f4grx/ol13/README.md

# ol13
1888 local oscillator, made after DF6NP design.
