f4grx/ol13/grx13.pdf

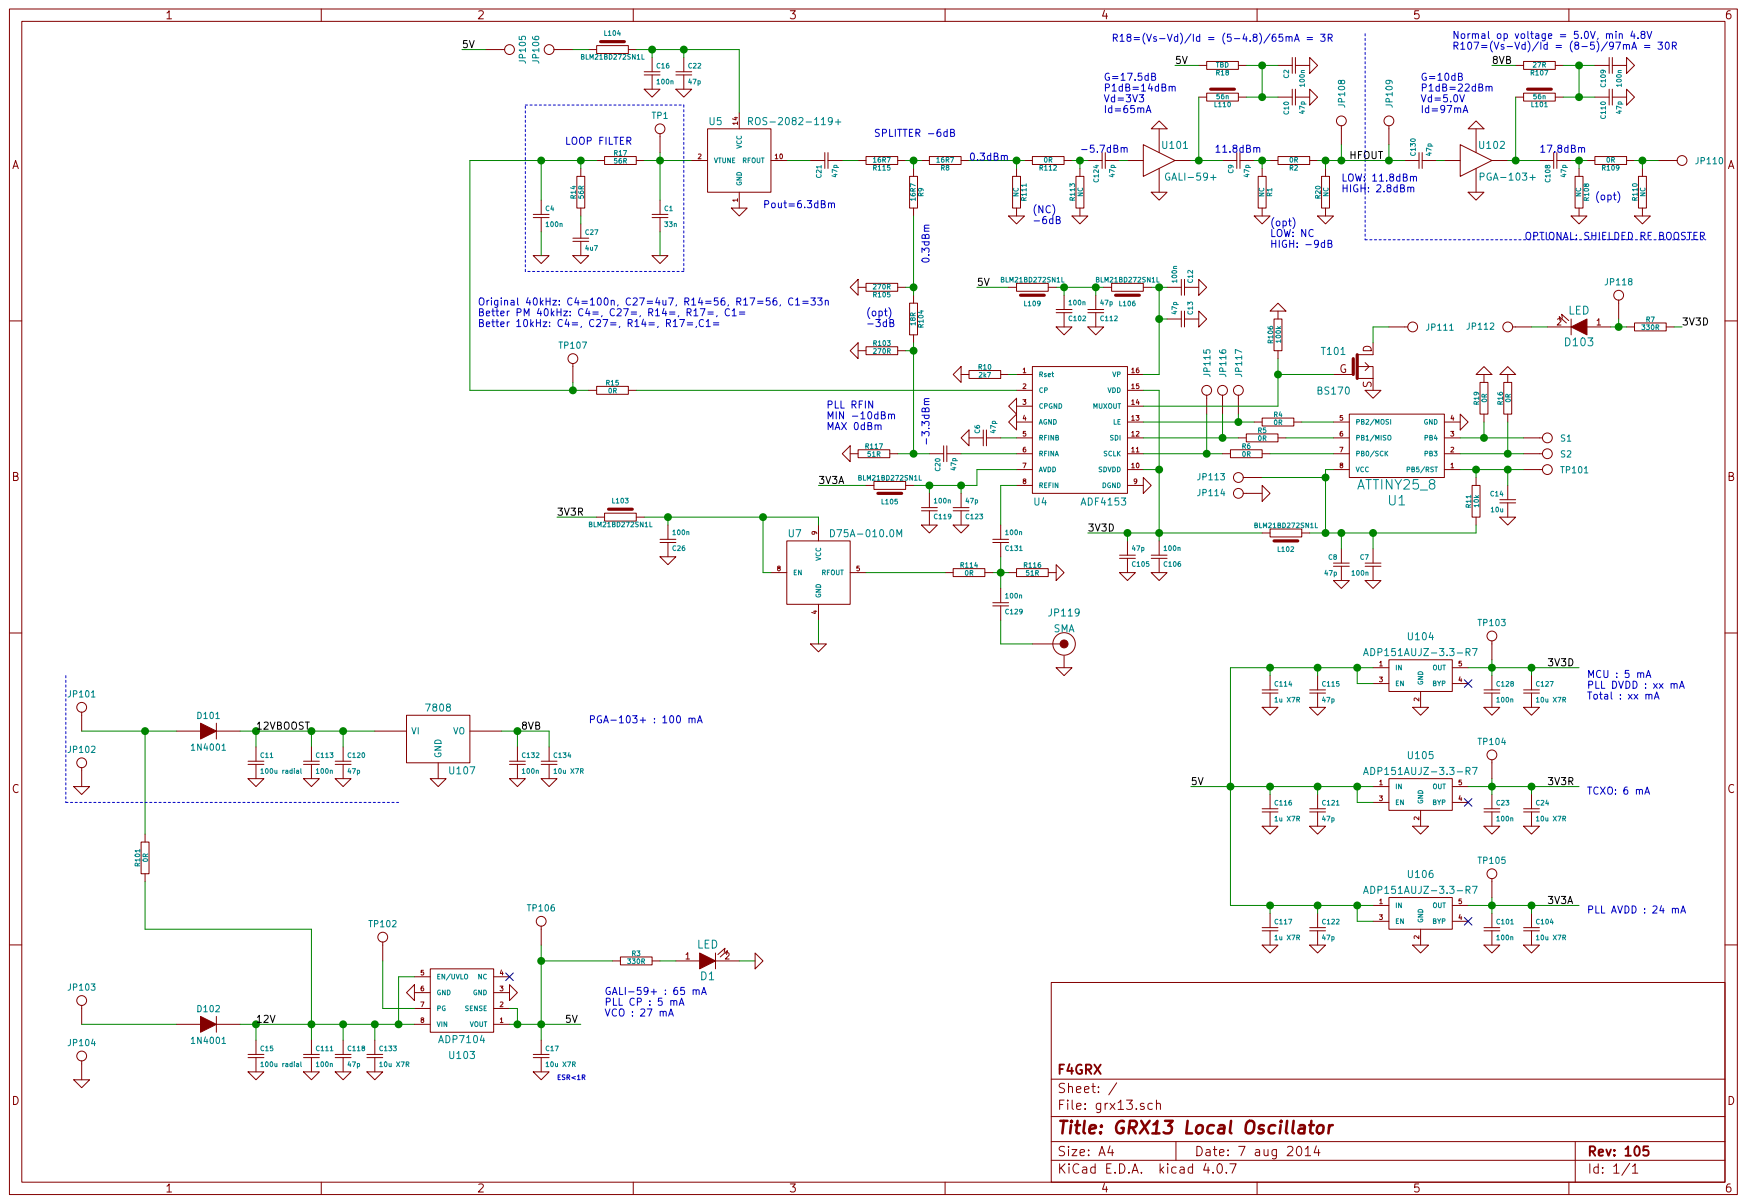
[picture p1: page 1]
