f4grx/ol13/grx13.kicad_pcb

## KiCad design grx13.kicad_pcb (2018-02-24)

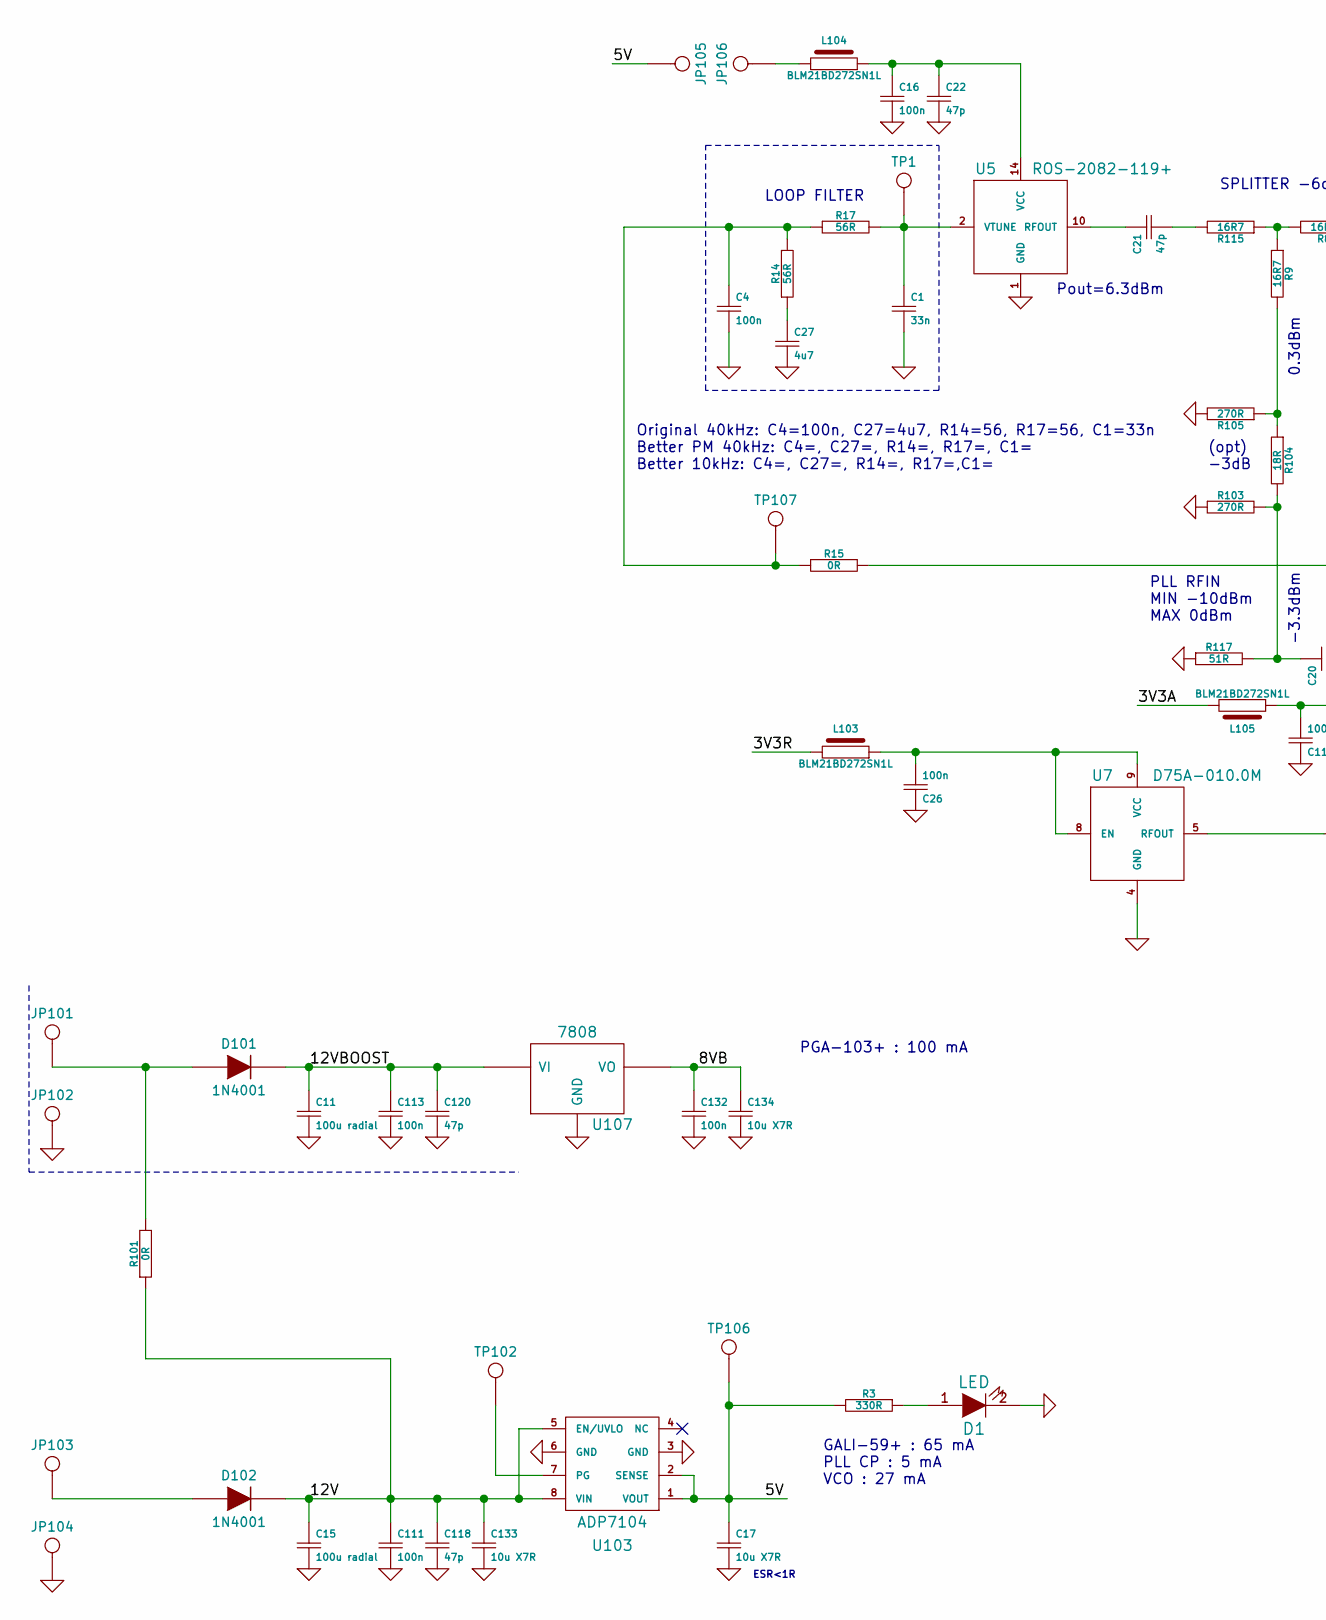
[picture p2: schematic grx13.sch, GRX13 Local Oscillator, part in row 1, column 1]

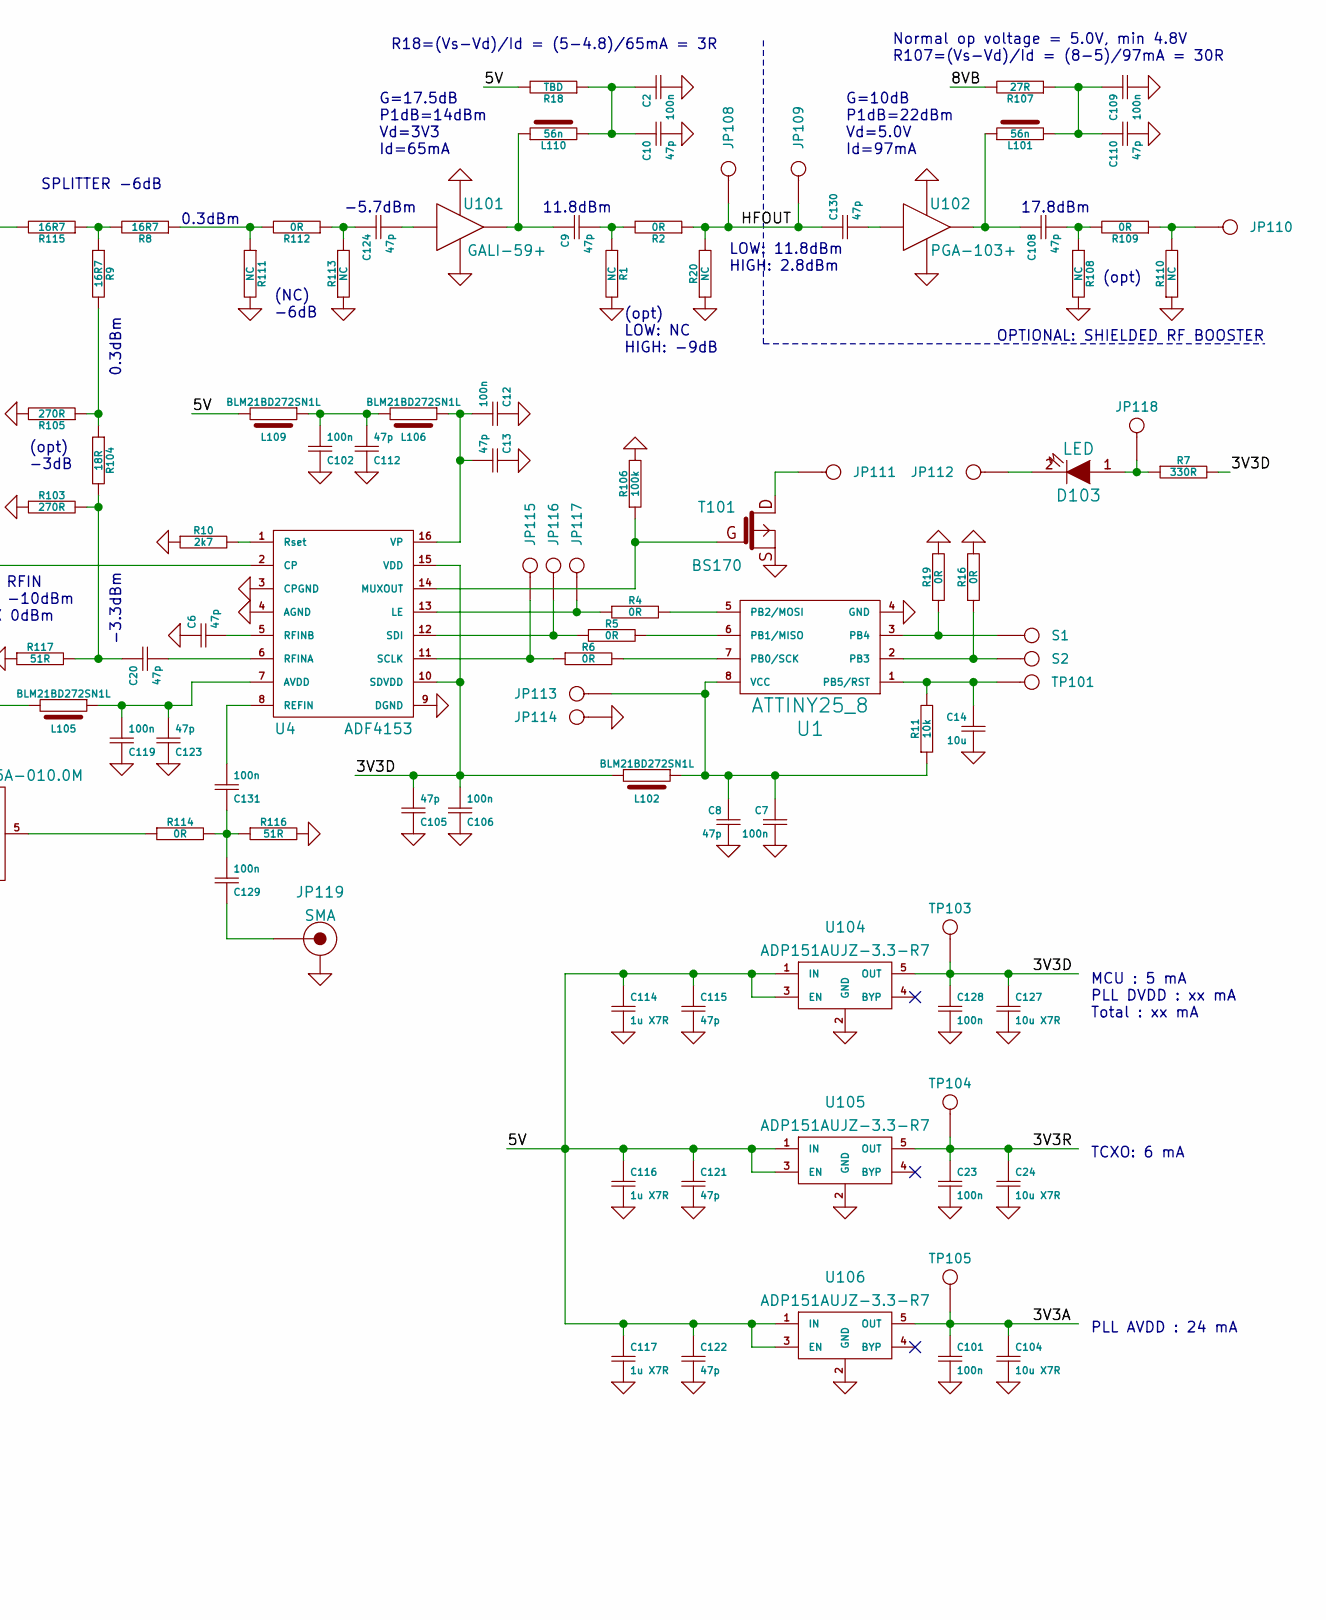
[picture p3: schematic grx13.sch, GRX13 Local Oscillator, part in row 1, column 2]

Parts:
C1: 33n; 0805
C2, C7, C12, C16, C23, C26, C101, C102, C106, C109, C111, C113, C119, C128, C129, C131, C132: 100n; 0805; PartNo 08055C104KAT2A; Farnell 499687
C4: 100n; 0805
C6, C8, C9, C10, C13, C20, C21, C22, C105, C108, C110, C112, C115, C118, C120, C121, C122, C123, C124, C130: 47p; 0805; PartNo 08051A470JAT2A; Farnell 499160
C11, C15: 100u radial; C2V8
C14: 10u; 1206
C17, C24, C104, C127, C133: 10u X7R; 1206; PartNo 1206YC106KAT2A; Farnell 1657943
C27: 4u7; 1206
C114: 1u X7R; 0805; PartNo C2012X7S2A105K125AB
C116, C117: 1u X7R; 0805
C134: 10u X7R; 1206; PartNo 1206YC106KAT2A
D1, D103: LED; 0805
D101, D102: 1N4001; D4
JP101: CONN_1; HOLE_PTH_R_08_16; PartNo nobom; Farnell F
JP102, JP103, JP104, JP105, JP106, JP111, JP112, JP113, JP114, JP115, JP116, JP117, JP118: CONN_1; HOLE_PTH_R_08_16; PartNo nobom
JP108, JP109, JP110: CONN_1; HOLE_SMD_S_15; PartNo nobom
JP119: SMA; SMA_TH; PartNo nobom
L101, L110: 56n; 0805
L102, L103, L104, L105, L106, L109: BLM21BD272SN1L; 0805; PartNo BLM21BD272SN1L; Farnell 1515647
R1, R20, R108, R110, R111, R113: NC; 0805
R2, R4, R5, R6, R15, R16, R19, R101, R109, R112, R114: 0R; 0805
R3, R7: 330R; 0805
R8, R9, R115: 16R7; 0805
R10: 2k7; 0805
R11: 10k; 0805
R14, R17: 56R; 0805
R18: TBD; 1206
R103, R105: 270R; 0805
R104: 18R; 0805
R106: 100k; 0805
R107: 27R; 1206
R116, R117: 51R; 0805
S1, S2: CONN_1; HOLE_PTH_R_08_16; PartNo nobom
T101: BS170; SOT23GDS; PartNo BS170FTA; Farnell 9526005
TP1, TP101, TP102, TP103, TP104, TP105, TP106, TP107: CONN_1; HOLE_PTH_R_06_12; PartNo nobom
U1: ATTINY25_8; SO8N; PartNo ATTINY25V-10SSU
U4: ADF4153; TSSOP16; PartNo ADF4153ABRUZ; Mouser 584-ADF4153ABRUZ
U5: ROS-2082-119+; CK605; PartNo ROS-2082-119+; Farnell NA
U7: D75A-010.0M; D75A; PartNo D75A-010.0M; Farnell NA
U101: GALI-59+; SOT89; PartNo GALI-59+; Farnell NA
U102: PGA-103+; SOT89; PartNo PGA-103+; Farnell NA
U103: ADP7104; SO8N; PartNo ADP7104ARDZ-5.0-R7; Farnell NA
U104, U105, U106: ADP151AUJZ-3.3-R7; SOT23-5; PartNo ADP151AUJZ-3.3-R7; Mouser 584-ADP151AUJZ-3.3R7
U107: 7808; DPAK2; PartNo MC7808CDTT5G; Farnell 1652338

Connections:
/3V3A: C101.1, C104.1, L105.2 (OUT), TP105.1, U106.5 (OUT)
/3V3D: C105.2, C106.2, C127.1, C128.1, L102.2 (OUT), R7.2 (OUT), TP103.1, U4.10 (SDVDD), U4.15 (VDD), U104.5 (OUT)
/3V3R: C23.1, C24.1, L103.2 (OUT), TP104.1, U105.5 (OUT)
/5V: C17.1, C114.1, C115.1, C116.1, C117.1, C121.1, C122.1, JP105.1, L109.2 (OUT), R3.2 (OUT), R18.2 (OUT), TP106.1, U103.1 (VOUT), U103.2 (SENSE), U104.1 (IN), U104.3 (EN), U105.1 (IN), U105.3 (EN), U106.1 (IN), U106.3 (EN)
/8VB: C132.1, C134.1, R107.2 (OUT), U107.3 (VO)
/12V: C15.1, C111.1, C118.1, C133.1, D102.2 (K), R101.1 (IN), U103.5 (EN/UVLO), U103.8 (VIN)
/12VBOOST: C11.1, C113.1, C120.1, D101.2 (K), U107.1 (VI)
/HFOUT: C130.1, JP108.1, JP109.1, R2.1 (IN), R20.2 (OUT)
GND: C1.2, C2.2, C4.2, C6.1, C7.2, C8.2, C10.2, C11.2, C12.1, C13.1, C14.2, C15.2, C16.2, C17.2, C22.2, C23.2, C24.2, C26.1, C27.2, C101.2, C102.1, C104.2, C105.1, C106.1, C109.2, C110.2, C111.2, C112.1, C113.2, C114.2, C115.2, C116.2, C117.2, C118.2, C119.1, C120.2, C121.2, C122.2, C123.1, C127.2, C128.2, C132.2, C133.2, C134.2, D1.2 (K), JP102.1, JP104.1, JP114.1, JP119.2, R1.2 (OUT), R10.1 (IN), R16.2 (OUT), R19.2 (OUT), R20.1 (IN), R103.1 (IN), R105.2 (OUT), R106.2 (OUT), R108.2 (OUT), R110.1 (IN), R111.2 (OUT), R113.1 (IN), R116.2 (OUT), R117.1 (IN), T101.S, U1.4 (GND), U4.3 (CPGND), U4.4 (AGND), U4.9 (DGND), U5.1 (GND), U7.4 (GND), U101.2 (GND), U102.2 (GND), U103.3 (GND), U103.6 (GND), U104.2 (GND), U105.2 (GND), U106.2 (GND), U107.2 (GND)
unnamed: C1.1, R17.2 (OUT), TP1.1, U5.2 (VTUNE)
unnamed: C4.1, R14.2 (OUT), R15.1 (IN), R17.1 (IN), TP107.1
unnamed: C6.2, U4.5 (RFINB)
unnamed: C7.1, C8.1, JP113.1, L102.1 (IN), R11.1 (IN), U1.8 (VCC)
unnamed: C9.1, L110.1 (IN), U101.3 (OUT)
unnamed: C9.2, R1.1 (IN), R2.2 (OUT)
unnamed: C2.1, C10.1, L110.2 (OUT), R18.1 (IN)
unnamed: C12.2, C13.2, L106.1 (IN), U4.16 (VP)
unnamed: C14.1, R11.2 (OUT), TP101.1, U1.1 (PB5/RST)
unnamed: C16.1, C22.1, L104.1 (IN), U5.14 (VCC)
unnamed: C20.1, R103.2 (OUT), R104.2 (OUT), R117.2 (OUT)
unnamed: C20.2, U4.6 (RFINA)
unnamed: C21.1, U5.10 (RFOUT)
unnamed: C21.2, R115.2 (OUT)
unnamed: C26.2, L103.1 (IN), U7.8 (EN), U7.9 (VCC)
unnamed: C27.1, R14.1 (IN)
unnamed: C102.2, C112.2, L106.2 (OUT), L109.1 (IN)
unnamed: C108.1, L101.1 (IN), U102.3 (OUT)
unnamed: C108.2, R108.1 (IN), R109.2 (OUT)
unnamed: C109.1, C110.1, L101.2 (OUT), R107.1 (IN)
unnamed: C119.2, C123.2, L105.1 (IN), U4.7 (AVDD)
unnamed: C124.1, R112.1 (IN), R113.2 (OUT)
unnamed: C124.2, U101.1 (IN)
unnamed: C129.1, JP119.1
unnamed: C129.2, C131.1, R114.2 (OUT), R116.1 (IN)
unnamed: C130.2, U102.1 (IN)
unnamed: C131.2, U4.8 (REFIN)
unnamed: D1.1 (A), R3.1 (IN)
unnamed: D101.1 (A), JP101.1, R101.2 (OUT)
unnamed: D102.1 (A), JP103.1
unnamed: D103.1 (A), JP118.1, R7.1 (IN)
unnamed: D103.2 (K), JP112.1
unnamed: JP106.1, L104.2 (OUT)
unnamed: JP110.1, R109.1 (IN), R110.2 (OUT)
unnamed: JP111.1, T101.D
unnamed: JP115.1, R6.1 (IN), U4.11 (SCLK)
unnamed: JP116.1, R5.1 (IN), U4.12 (SDI)
unnamed: JP117.1, R4.1 (IN), U4.13 (LE)
unnamed: R4.2 (OUT), U1.5 (PB2/MOSI)
unnamed: R5.2 (OUT), U1.6 (PB1/MISO)
unnamed: R6.2 (OUT), U1.7 (PB0/SCK)
unnamed: R10.2 (OUT), U4.1 (Rset)
unnamed: R15.2 (OUT), U4.2 (CP)
unnamed: R16.1 (IN), S2.1, U1.2 (PB3)
unnamed: R19.1 (IN), S1.1, U1.3 (PB4)
unnamed: R9.2 (OUT), R104.1 (IN), R105.1 (IN)
unnamed: R106.1 (IN), T101.G, U4.14 (MUXOUT)
unnamed: R8.1 (IN), R111.1 (IN), R112.2 (OUT)
unnamed: R114.1 (IN), U7.5 (RFOUT)
unnamed: R8.2 (OUT), R9.1 (IN), R115.1 (IN)
unnamed: TP102.1, U103.7 (PG)

Notes on the sheet:
OPTIONAL: SHIELDED RF BOOSTER
(opt) -3dB
(NC) -6dB
(opt) LOW: NC HIGH: -9dB
LOOP FILTER
Pout=6.3dBm
SPLITTER -6dB
G=10dB P1dB=22dBm Vd=5.0V Id=97mA
G=17.5dB P1dB=14dBm Vd=3V3 Id=65mA
0.3dBm
PLL RFIN MIN -10dBm MAX 0dBm
-3.3dBm
-5.7dBm
11.8dBm
LOW: 11.8dBm HIGH: 2.8dBm
17.8dBm
(opt)
R18=(Vs-Vd)/Id = (5-4.8)/65mA = 3R
Normal op voltage = 5.0V, min 4.8V R107=(Vs-Vd)/Id = (8-5)/97mA = 30R
MCU : 5 mA PLL DVDD : xx mA Total : xx mA
TCXO: 6 mA
PLL AVDD : 24 mA
PGA-103+ : 100 mA
GALI-59+ : 65 mA PLL CP : 5 mA VCO : 27 mA
ESR<1R
Original 40kHz: C4=100n, C27=4u7, R14=56, R17=56, C1=33n Better PM 40kHz: C4=, C27=, R14=, R17=, C1= Better 10kHz: C4=, C27=, R14=, R17=,C1=

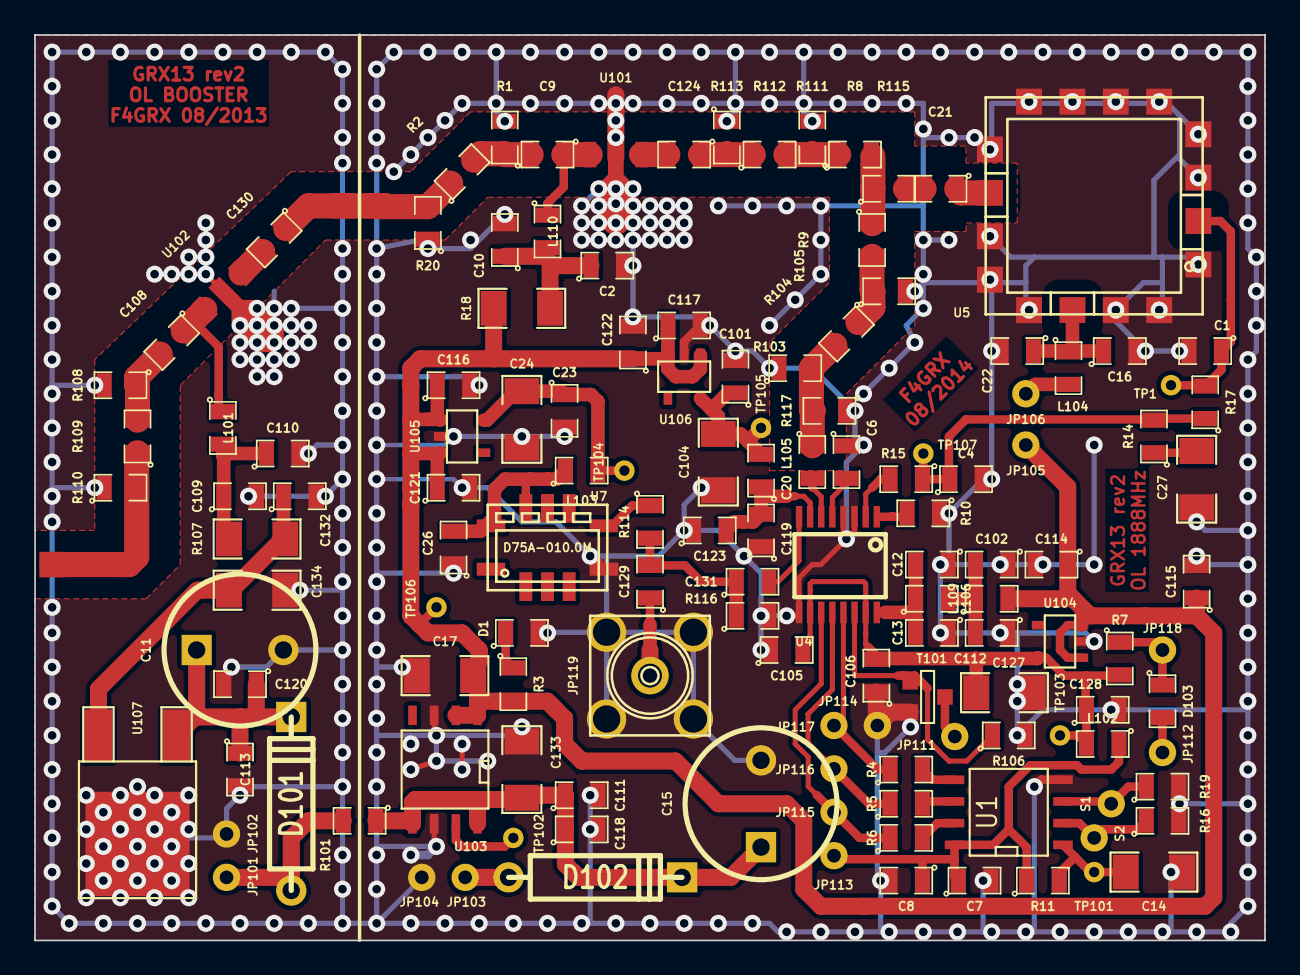
[picture p4: board grx13.kicad_pcb from above]

Board: 2 copper layers, 72.0 x 53.0 mm, 138 parts (0 on the bottom side), 60 nets.
